1stage/aqplus-controller/case/images/Aq+ Gamepad rev0x v11.png

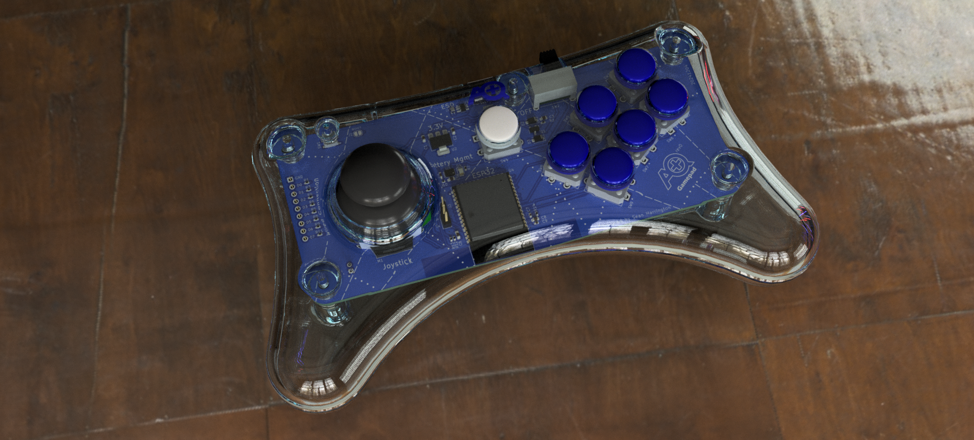
case/images/Aq+ Gamepad rev0x v11.png
