1stage/aqplus-controller/pcb/rev1/aqp_controller/images/Bottom Silkscreen.png

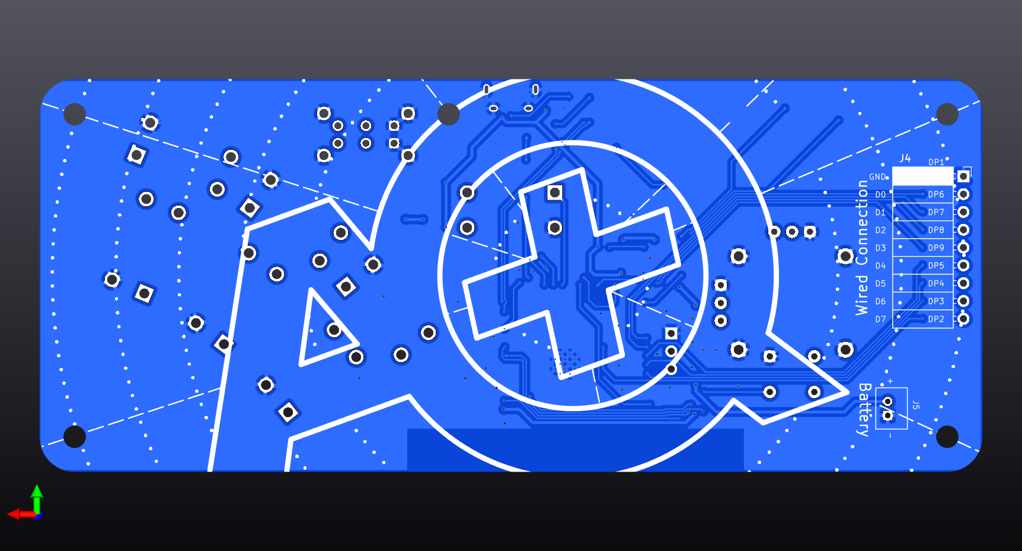
pcb/rev1/aqp_controller/images/Bottom Silkscreen.png
