1stage/aqplus-controller/pcb/rev1/aqp_controller/images/franks_battery_circuit.jpg

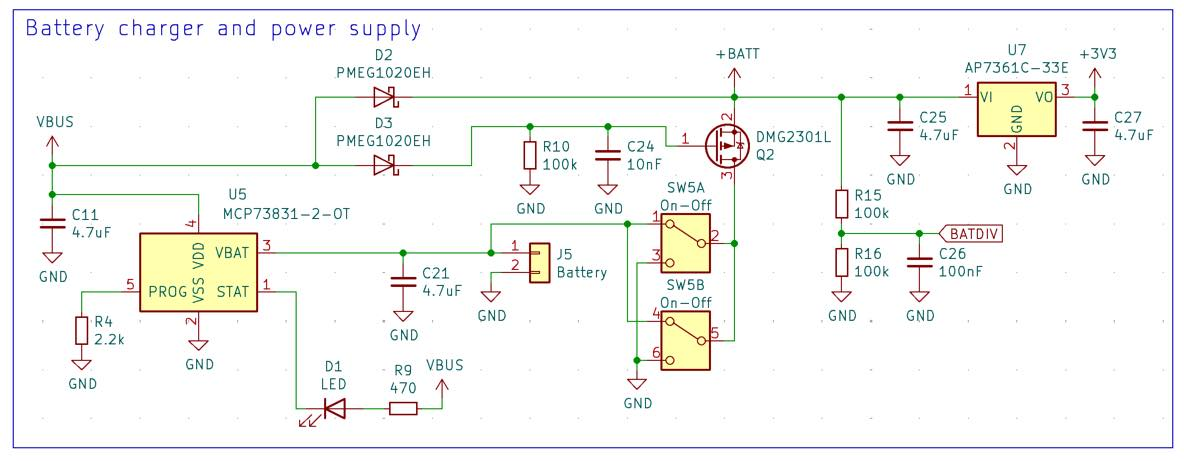
pcb/rev1/aqp_controller/images/franks_battery_circuit.jpg
