1stage/aqplus-controller/pcb/rev1/aqp_controller/images/grey_specklestone.png

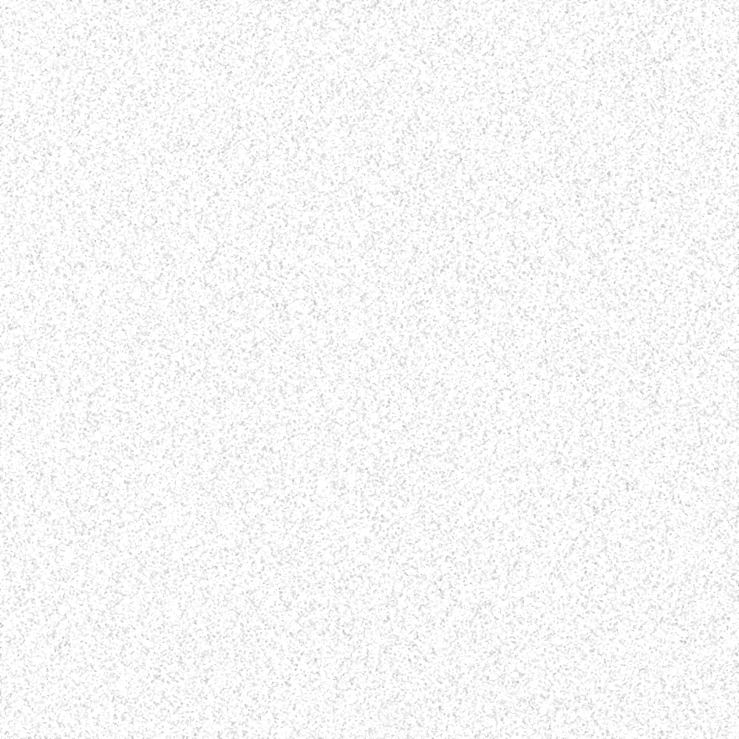
pcb/rev1/aqp_controller/images/grey_specklestone.png
