1stage/aqplus-controller/pcb/rev1/aqp_controller/images/Other Schematic.png

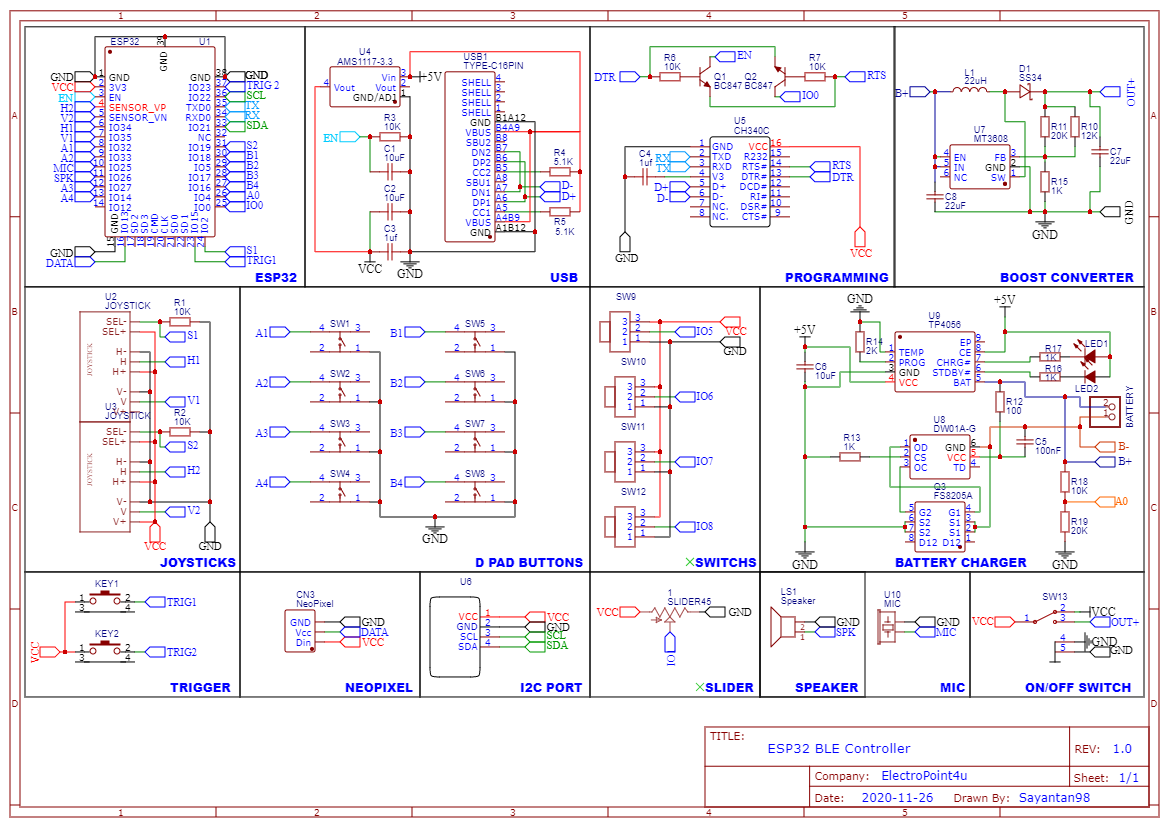
pcb/rev1/aqp_controller/images/Other Schematic.png
