1stage/aqplus-controller/pcb/rev1/aqp_controller/images/Top Silkscreen.png

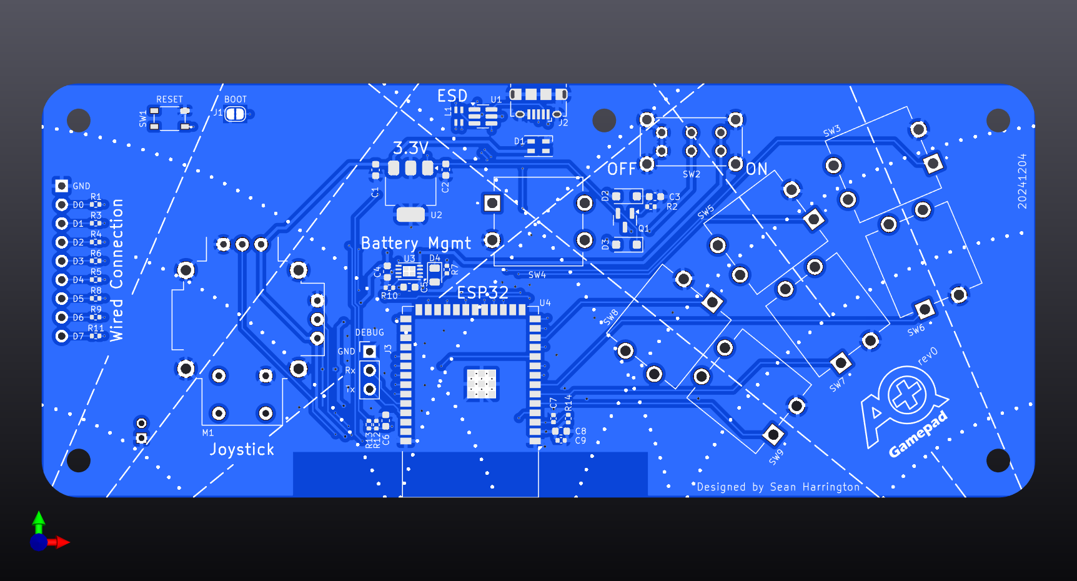
pcb/rev1/aqp_controller/images/Top Silkscreen.png
