1stage/aqplus-controller/case/aqgp_button.stl

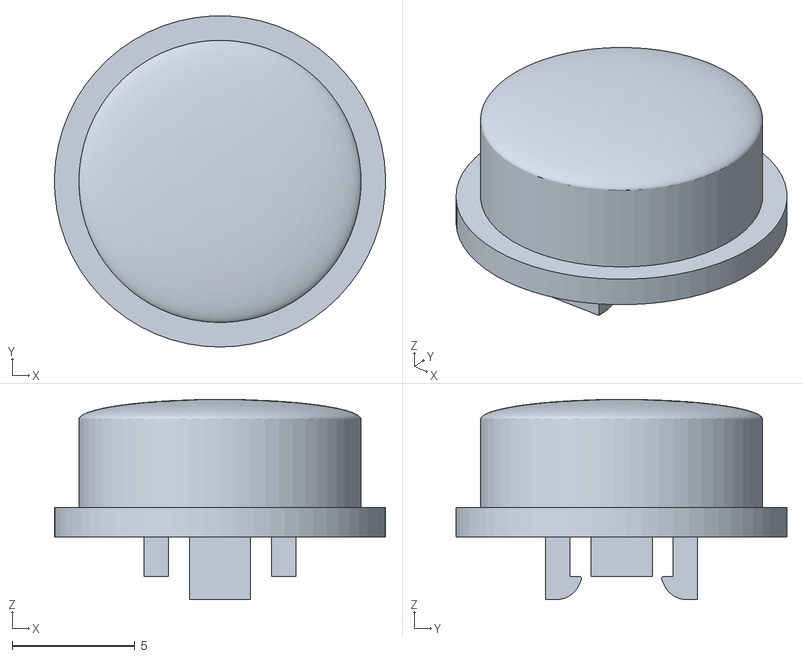
[picture p8: CAD file, 2025-03-24]
case/aqgp_button.stl
13.5 x 13.5 x 8.16
