1stage/aqplus-controller/case/aqgp_button_tree.3mf

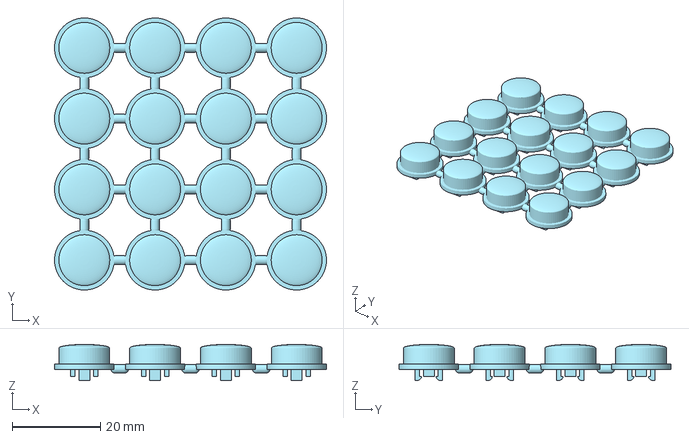
[picture p9: CAD file, 2025-03-24]
case/aqgp_button_tree.3mf
61.5 x 61.5 x 8.16 mm
