1stage/aqplus-controller/pcb/rev1/aqp_controller/step/1N5819HW-7-F.step

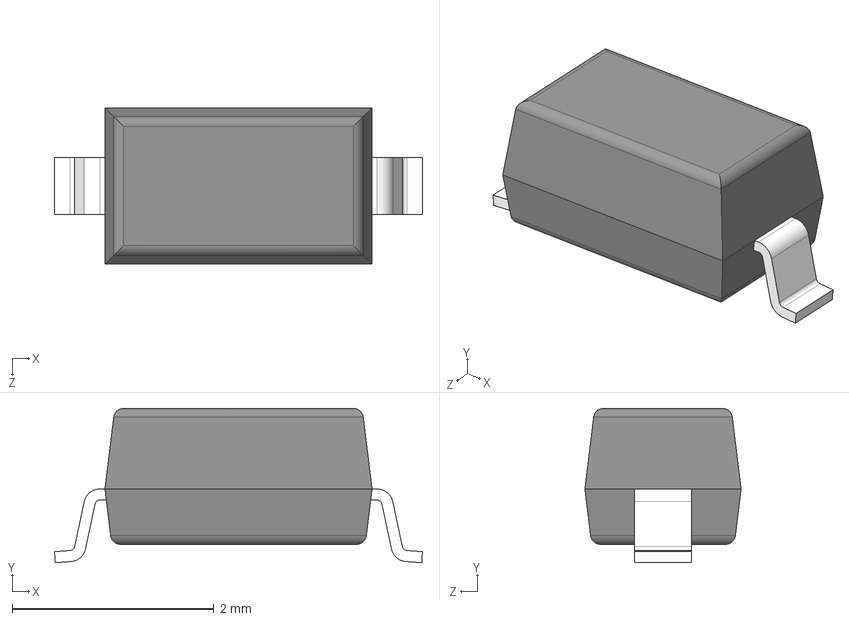
[picture p10: CAD file, 2024-11-10]
pcb/rev1/aqp_controller/step/1N5819HW-7-F.step
3.65 x 1.53 x 1.55 mm
