1stage/aqplus-controller/case/aqgp_thumb_hat v2.3mf

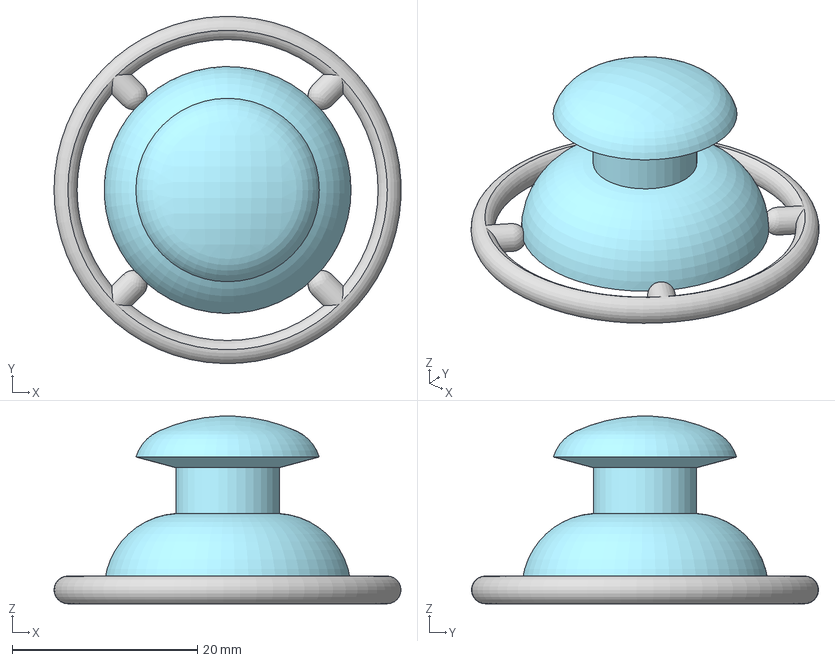
[picture p11: CAD file, 2025-03-24]
case/aqgp_thumb_hat v2.3mf
37.5 x 37.5 x 20.3 mm
Sprue Ring
Thumb Hat
