1stage/aqplus-controller/pcb/rev1/aqp_controller/step/LESD5D5.0CT1G.step

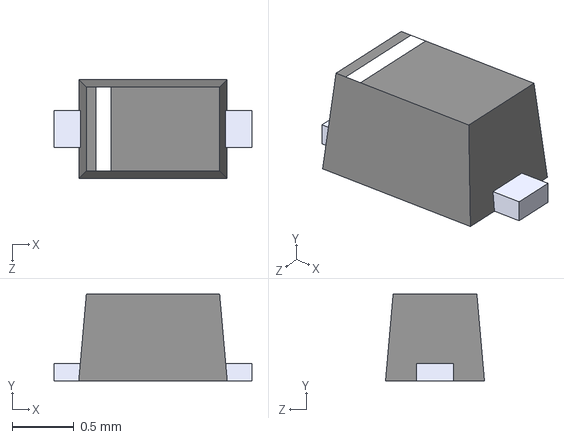
[picture p12: CAD file, 2024-11-10]
pcb/rev1/aqp_controller/step/LESD5D5.0CT1G.step
1.60 x 0.7 x 0.8 mm
