1stage/aqplus-controller/case/aqgp_case_top.stl

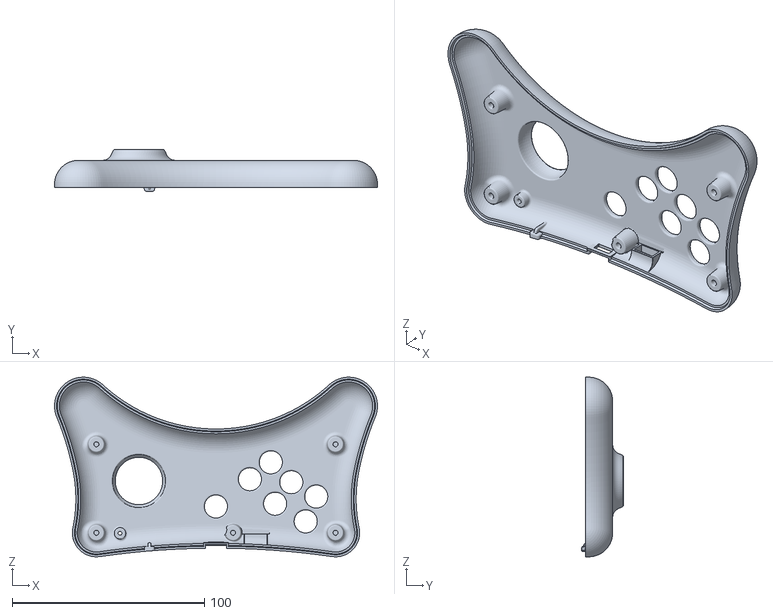
[picture p13: CAD file, 2025-02-26]
case/aqgp_case_top.stl
168.0 x 21.6 x 93.4
