1stage/aqplus-controller/case/aqgp_case_bottom.stl

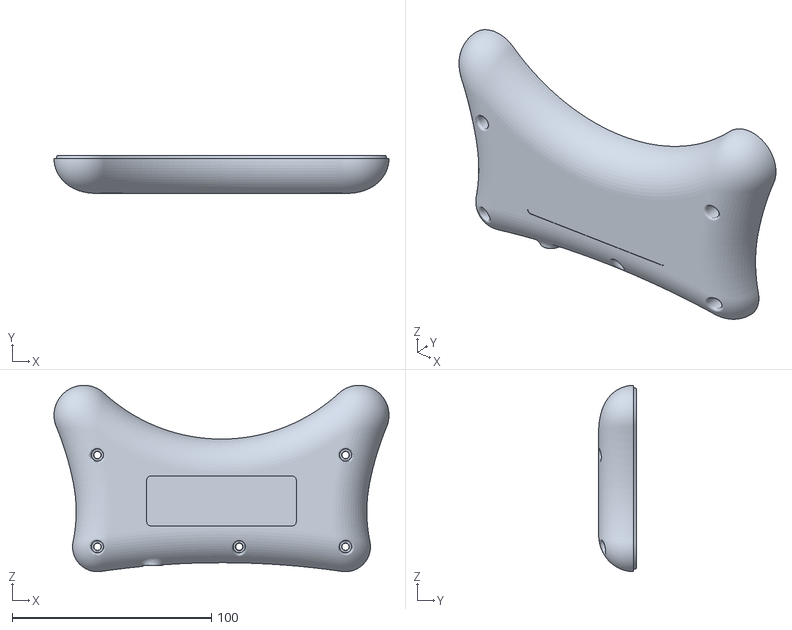
[picture p14: CAD file, 2025-02-26]
case/aqgp_case_bottom.stl
168.0 x 18.9 x 93.4
