1stage/aqplus-controller/pcb/rev1/aqp_controller/step/FS8205.step

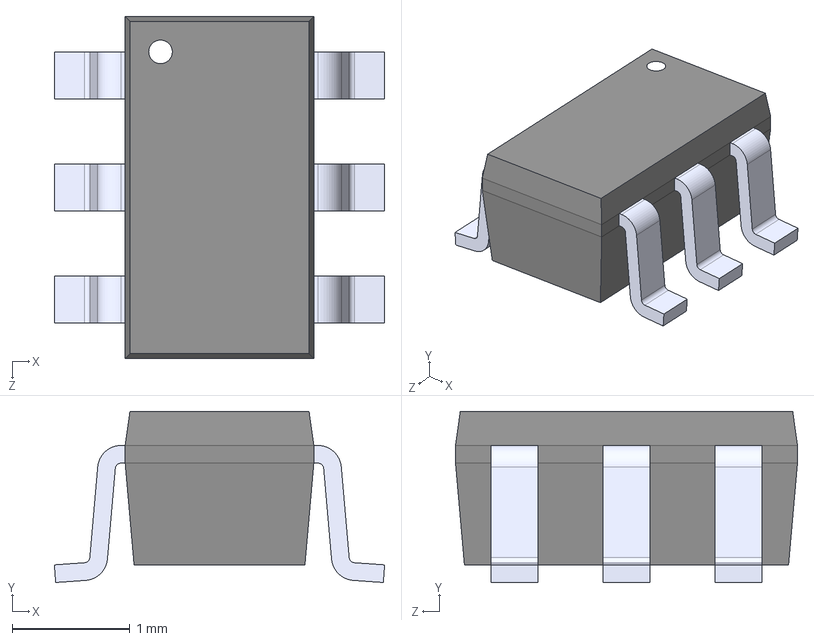
[picture p15: CAD file, 2024-11-10]
pcb/rev1/aqp_controller/step/FS8205.step
2.80 x 1.45 x 2.90 mm
