1stage/aqplus-controller/case/aqgp_case_plug.stl

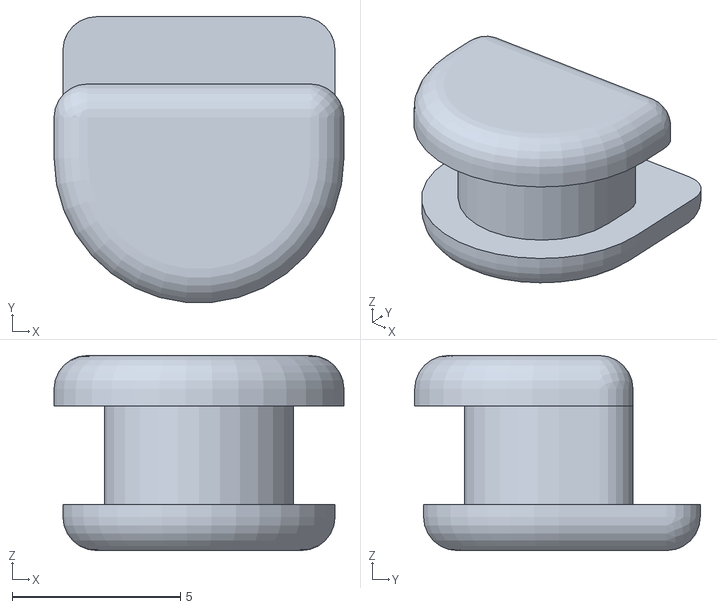
[picture p16: CAD file, 2025-02-26]
case/aqgp_case_plug.stl
8.62 x 8.49 x 5.80
