1stage/aqplus-controller/pcb/rev1/aqp_controller/step/LD09S33E4GX00LF.step

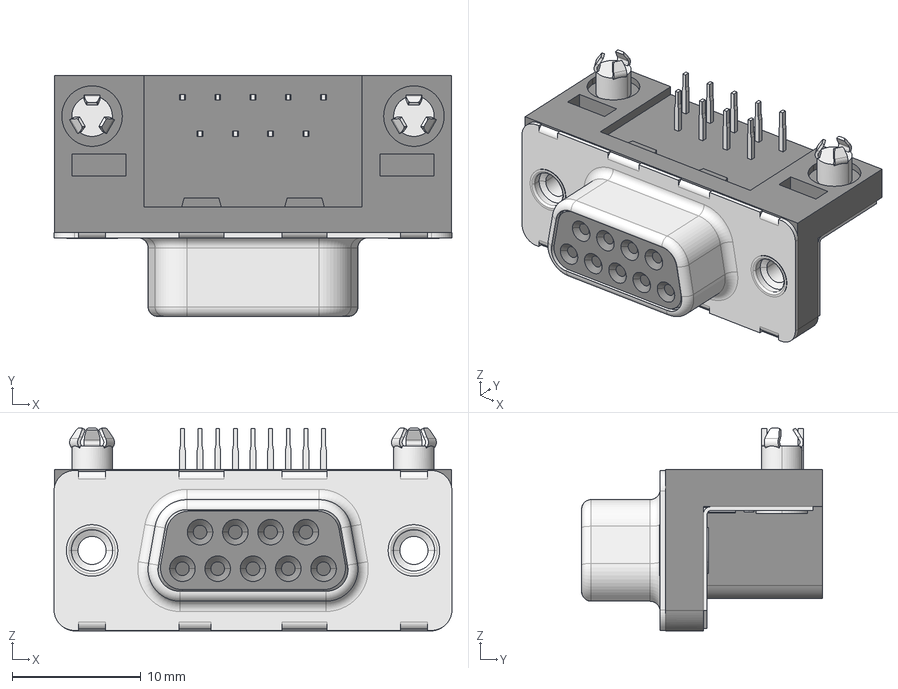
[picture p17: CAD file, 2024-11-10]
pcb/rev1/aqp_controller/step/LD09S33E4GX00LF.step
30.9 x 18.7 x 15.8 mm
