1stage/aqplus-controller/case/aqgp_thumb_cap.stl

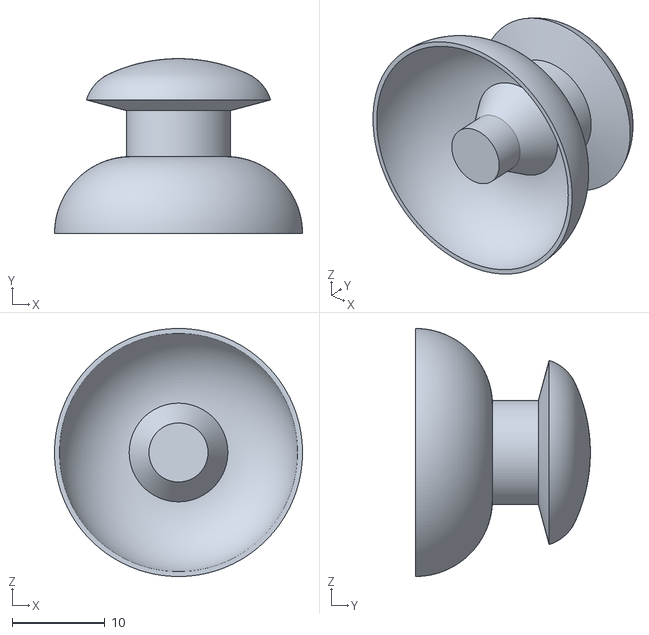
[picture p18: CAD file, 2025-02-26]
case/aqgp_thumb_cap.stl
26.7 x 18.8 x 26.7
