1stage/aqplus-controller/pcb/rev1/aqp_controller/step/SKRPACE010_COLOR.step

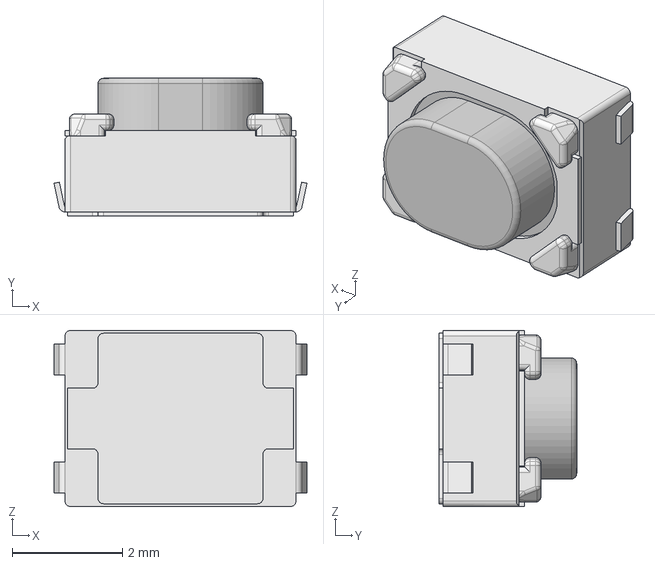
[picture p19: CAD file, 2024-11-10]
pcb/rev1/aqp_controller/step/SKRPACE010_COLOR.step
4.60 x 2.50 x 3.20 mm
