1stage/aqplus-controller/pcb/rev1/aqp_controller/step/B2B-PH-K-S_LF__SN_.step

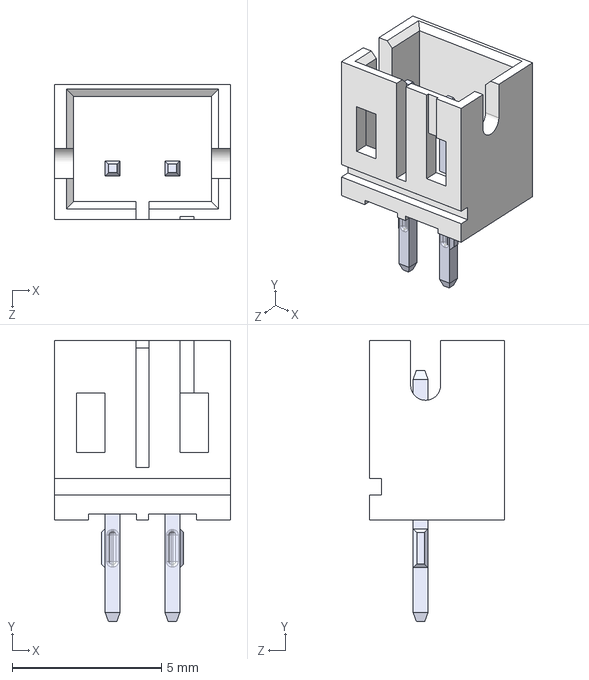
[picture p20: CAD file, 2024-11-10]
pcb/rev1/aqp_controller/step/B2B-PH-K-S_LF__SN_.step
5.90 x 9.40 x 4.50 mm
