1stage/aqplus-controller/pcb/rev1/aqp_controller/step/PinHeader_2x03_P2.54mm_Vertical.step

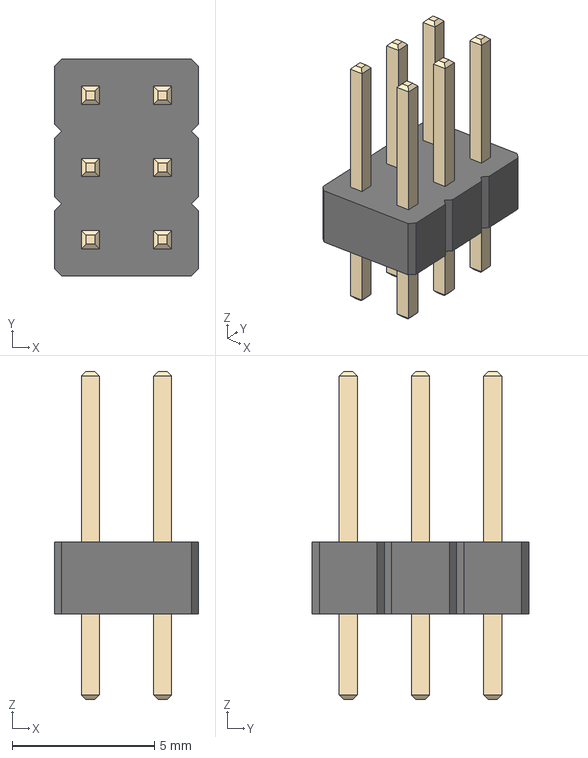
[picture p21: CAD file, 2024-11-10]
pcb/rev1/aqp_controller/step/PinHeader_2x03_P2.54mm_Vertical.step
5.08 x 7.62 x 11.5 mm
