1stage/aqplus-controller/pcb/rev1/aqp_controller/step/COM-09032.step

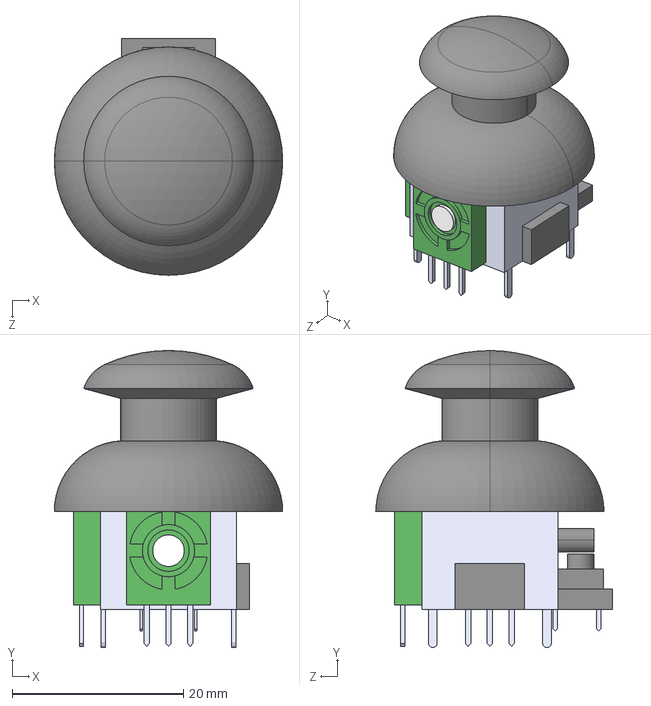
[picture p22: CAD file, 2024-11-10]
pcb/rev1/aqp_controller/step/COM-09032.step
26.7 x 34.7 x 27.6 mm
