1stage/aqplus-controller/pcb/rev1/aqp_controller/step/TP4056-42-ESOP8.step

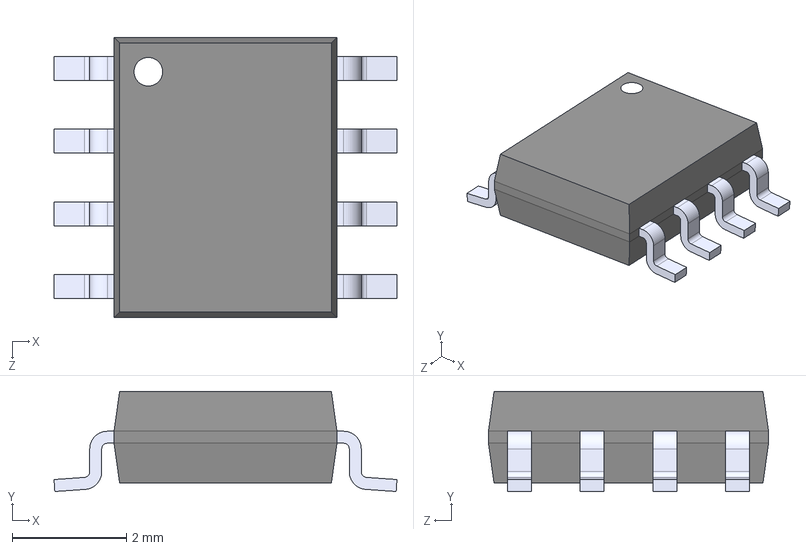
[picture p23: CAD file, 2024-11-10]
pcb/rev1/aqp_controller/step/TP4056-42-ESOP8.step
6.00 x 1.75 x 4.90 mm
