1stage/aqplus-controller/pcb/rev1/aqp_controller/step/TL1100F160Q.step

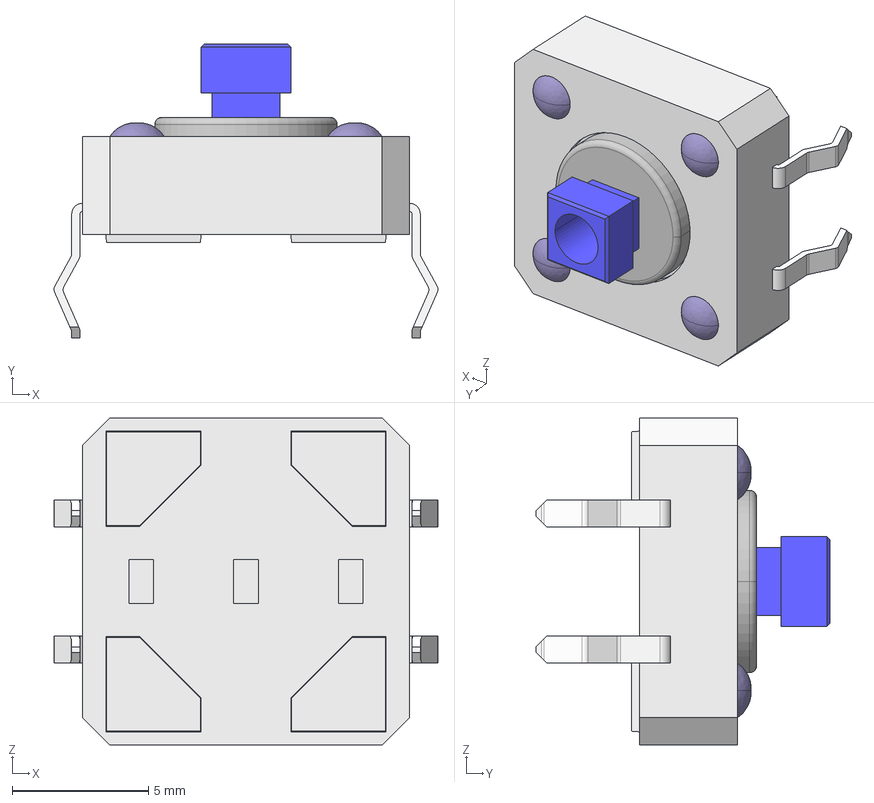
[picture p24: CAD file, 2024-11-10]
pcb/rev1/aqp_controller/step/TL1100F160Q.step
14.1 x 10.8 x 12.0 mm
