1stage/aqplus-controller/pcb/rev1/aqp_controller/step/2x03-T Pin Header.step

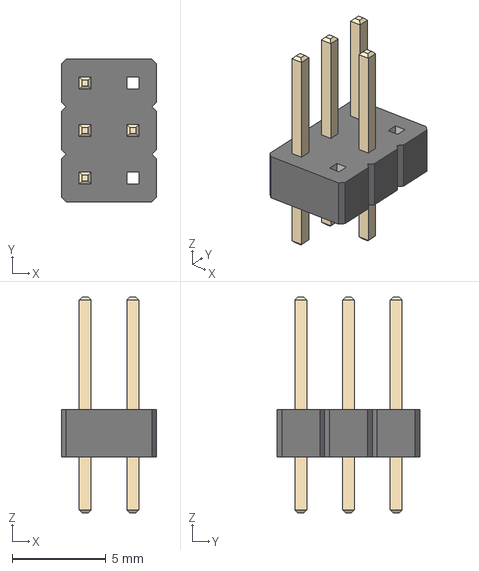
[picture p25: CAD file, 2024-11-10]
pcb/rev1/aqp_controller/step/2x03-T Pin Header.step
5.08 x 7.62 x 11.5 mm
