1stage/aqplus-controller/(list of files, cad)

Other CAD files:
pcb/rev1/aqp_controller/step/12mm_button_top_BLUE.step
pcb/rev1/aqp_controller/step/12mm_button_top.step
pcb/rev1/aqp_controller/step/12mm_button_top_WHITE.step
case/aqgp_button.f3d
case/aqgp_thumb_hat.f3d
pcb/rev1/aqp_controller/step/10118194-0001LF.stp
pcb/rev1/aqp_controller/step/744231091.stp
pcb/rev1/aqp_controller/step/90380A110_Phillips Rounded Head Thread-Forming Screws.STEP
pcb/rev1/aqp_controller/step/JS202011JCQN.step
