1stage/aqplus-controller/pcb/rev1/aqp_controller/component_downloads/2108131530_Korean-Hroparts-Elec-K6-6140D-03_C124869.pdf

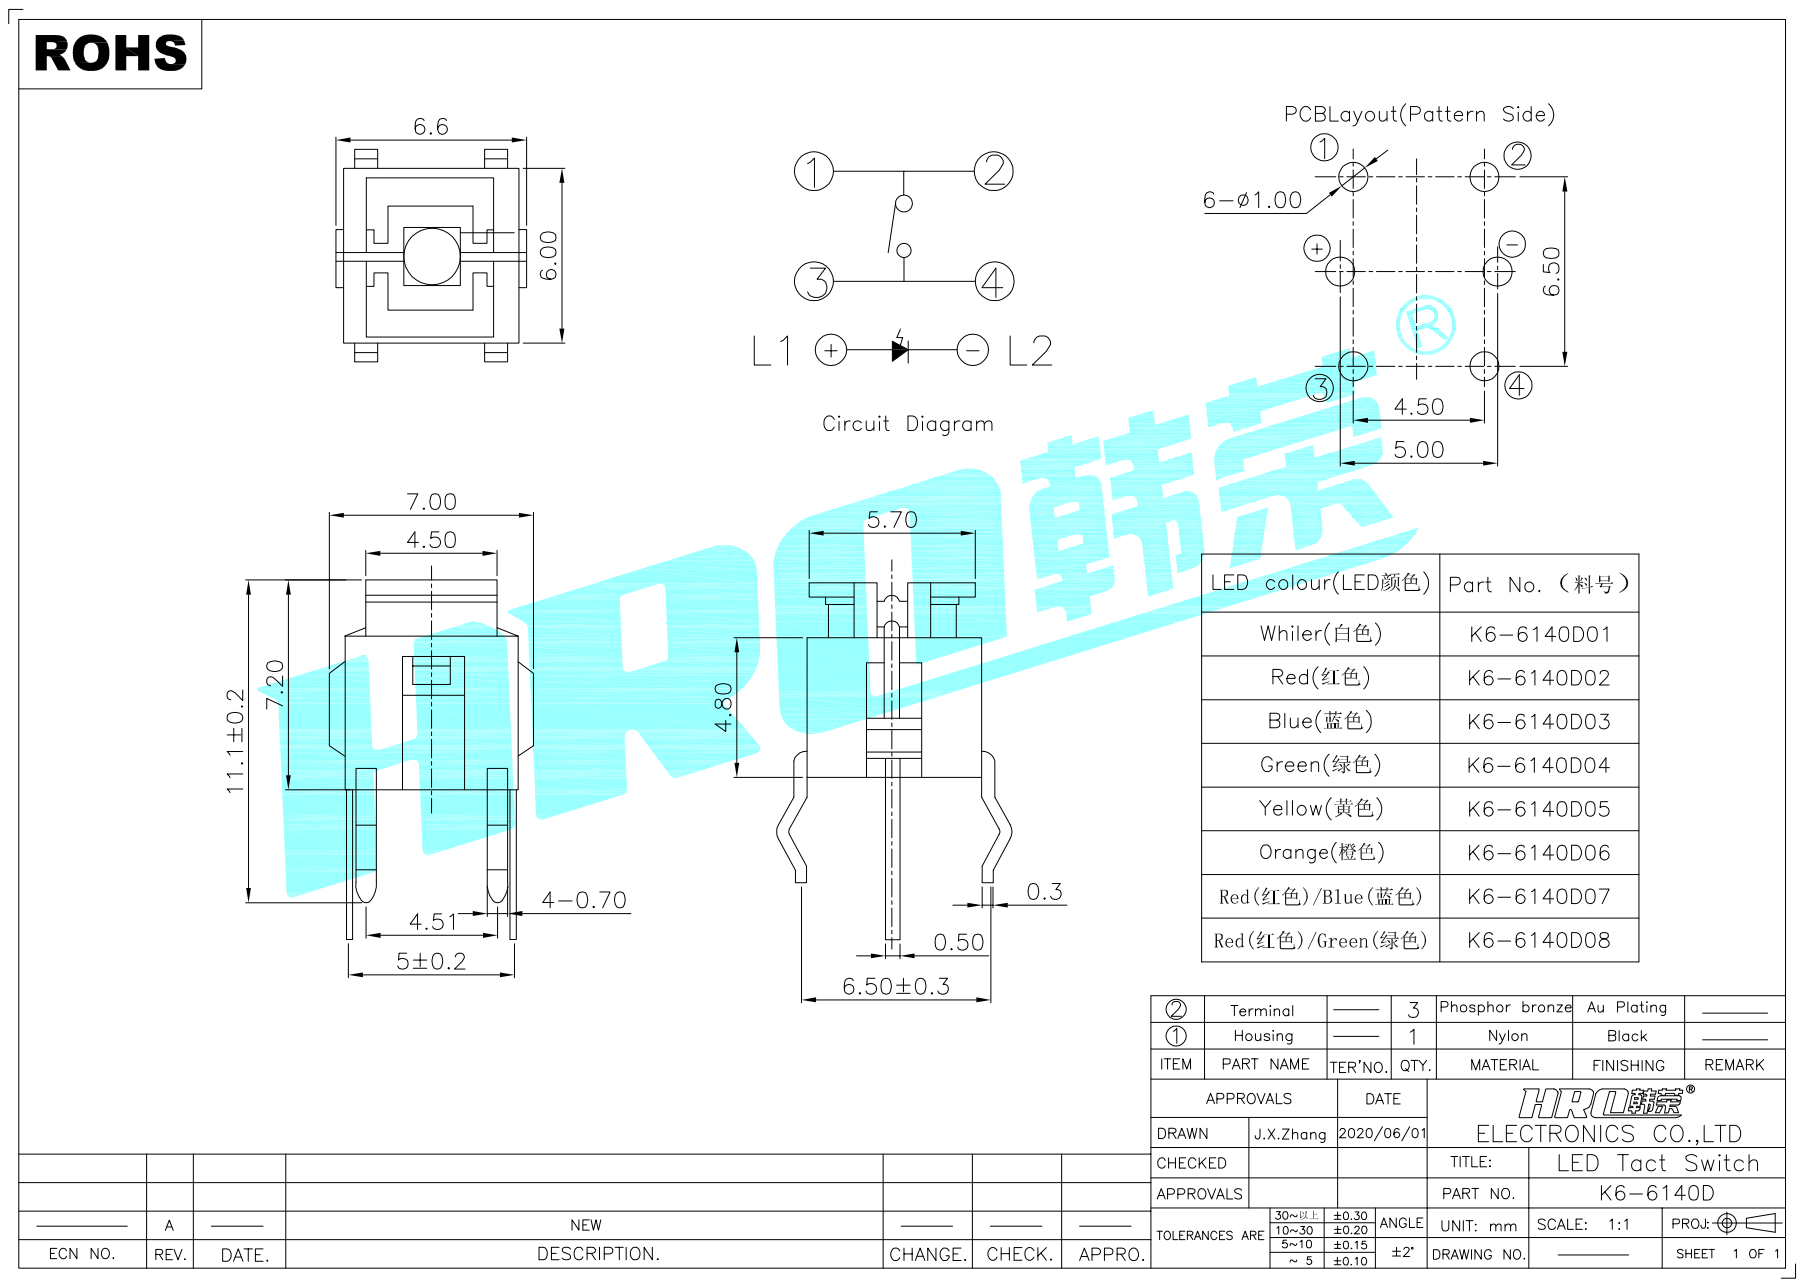
[picture p26: page 1]
