1stage/aqplus-controller/code/AQP_Gamepad/Unit_Settings.ino

/*

Aq+ Gamepad - Unit Settings File
--------------------------------------------------------------------------------------------
by Sean P. Harrington
sph@1stage.com
aquarius.1stage.com
--------------------------------------------------------------------------------------------
Updated - 26 Feb 2025

*/

// Change for each new unit OR to match old units as they are upgraded
#define AQGP_SRLN "AQGP-xxxx-CC"    // Serial number for this specific device (change for each unit)

// Change as SW/FM and HW versions are updated
#define AQGP_MODL "1.0"             // Model number of device
#define AQGP_SWFM "0.5.0"           // Software/firmware version (should align with newest Revision number in Docs.ino file)
#define AQGP_HWRV "rev0"            // Hardware revision

// Do not change
#define AQGP_NAME "Aq+ Gamepad"     // BTLE broadcast name for device
#define AQGP_MNFR "1STAGE"          // Manufacturer of device
#define AQGP_BATT 100               // Starting battery level
