1stage/aqplus-controller/(commit log)

2024-11-10 Large Push
    [10118194-0001LF.stp, 12mm_button_top.step, 12mm_button_top_BLUE.step, 12mm_button_top_WHITE.step, 1N5819HW-7-F.step, 2x03-T Pin Header.step, 744231091.stp, B2B-PH-K-S_LF__SN_.step]
2025-02-26 Big update, post CODE completion
    [10118194-0001LF.stp, 1N5819HW-7-F.step, 90380A110_Phillips Rounded Head Thread-Forming Screws.STEP, Big Battery.obj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]
2025-02-26 Separated large block of documentation in main header to Docs.ino
    Also added Layout function to show DPAD and Button Row Swap status.
    [AQP_Gamepad.ino, Docs.ino, Unit_Settings.ino]
2025-02-26 Folder reorg
    [Big Battery.obj, lipo_charger.kicad_sch]
2025-02-26 Create Aq+ Gamepad Prototype Beauty Shot.png
2025-03-24 Updates for case and rev1 PCB
    [10118194-0001LF.stp, 12mm_button_top.step, 12mm_button_top_BLUE.step, 12mm_button_top_WHITE.step, 1N5819HW-7-F.step, 2x03-T Pin Header.step, 744231091.stp, 90380A110_Phillips Rounded Head Thread-Forming Screws.STEP]
2025-03-24 Made DB9 Pin 1 switchable
    [aqp_controller.kicad_pcb, aqp_controller.kicad_sch]
2025-03-24 Added code and PCB updates for DB9 Pin 1 (DATAPIN_8) as GND
    [aqp_controller.kicad_pcb, aqp_controller.kicad_sch]
2025-03-26 Minor tweaks to rev1
    [aqp_controller.kicad_pcb, aqp_controller.kicad_sch]
